florianheller/PocketLogic/docs/img/case.png

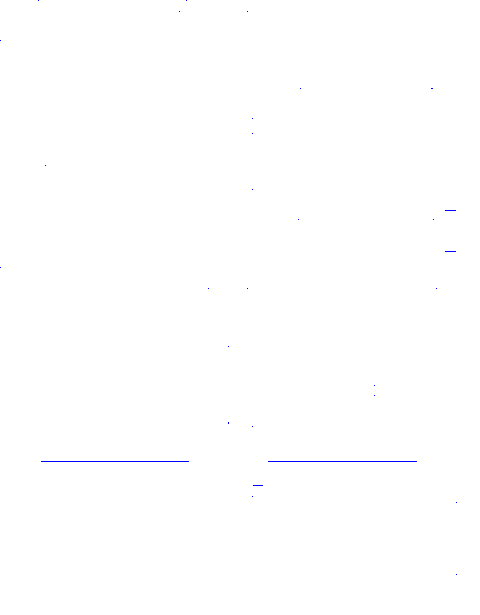
docs/img/case.png
