florianheller/PocketLogic/docs/img/schematics.pdf

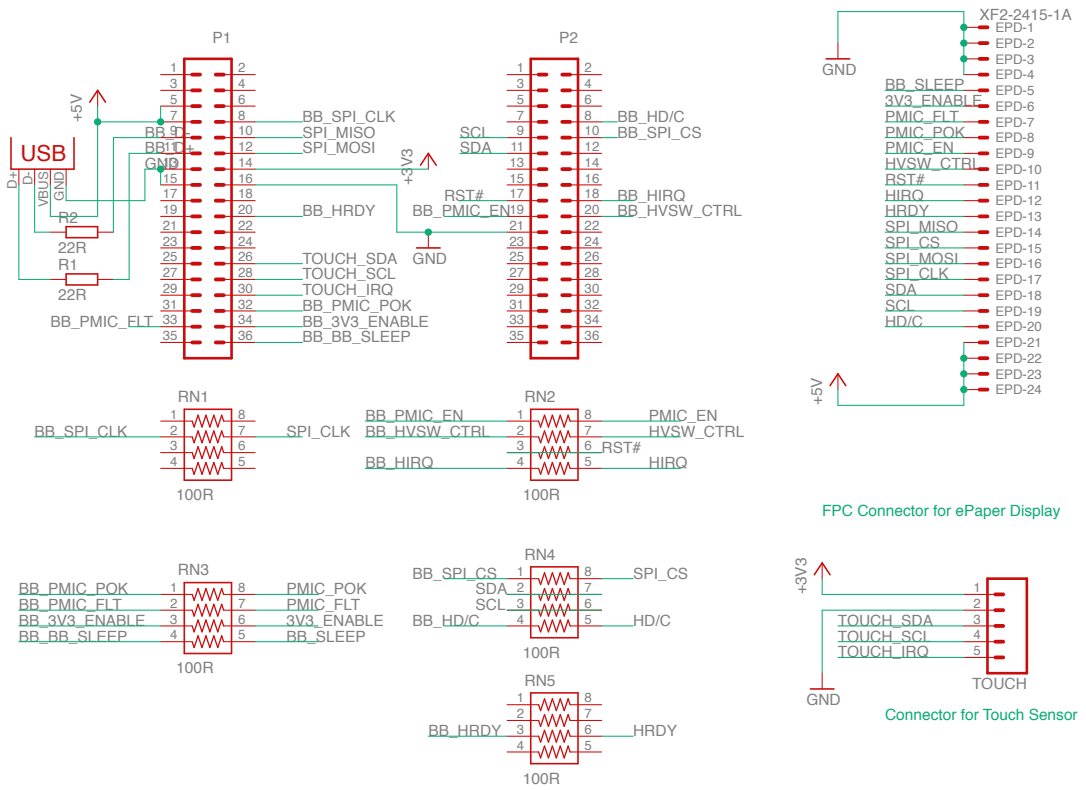
[picture p4: page 1]

FPC Connector for ePaper Display

Connector for Touch Sensor
