florianheller/PocketLogic/docs/img/board.pdf

1

36

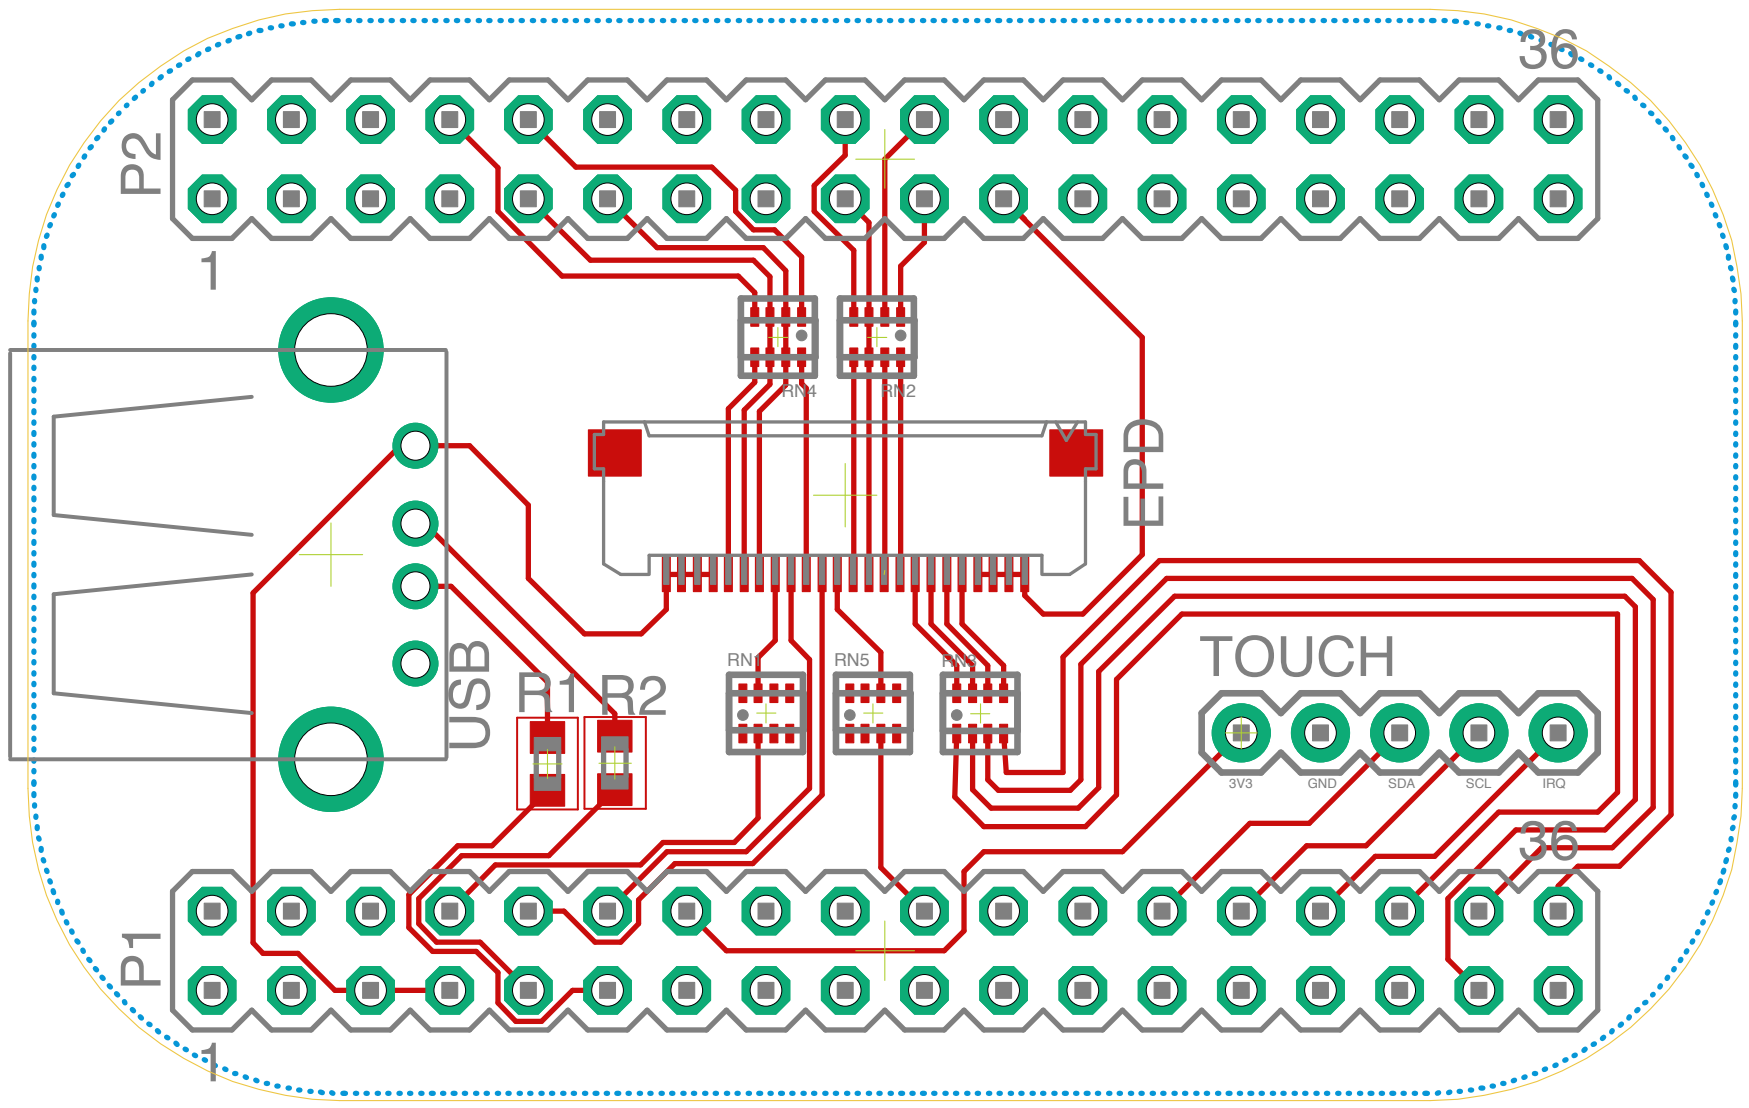
[picture p5: page 1]
