florianheller/PocketLogic/docs/resources/case.pdf

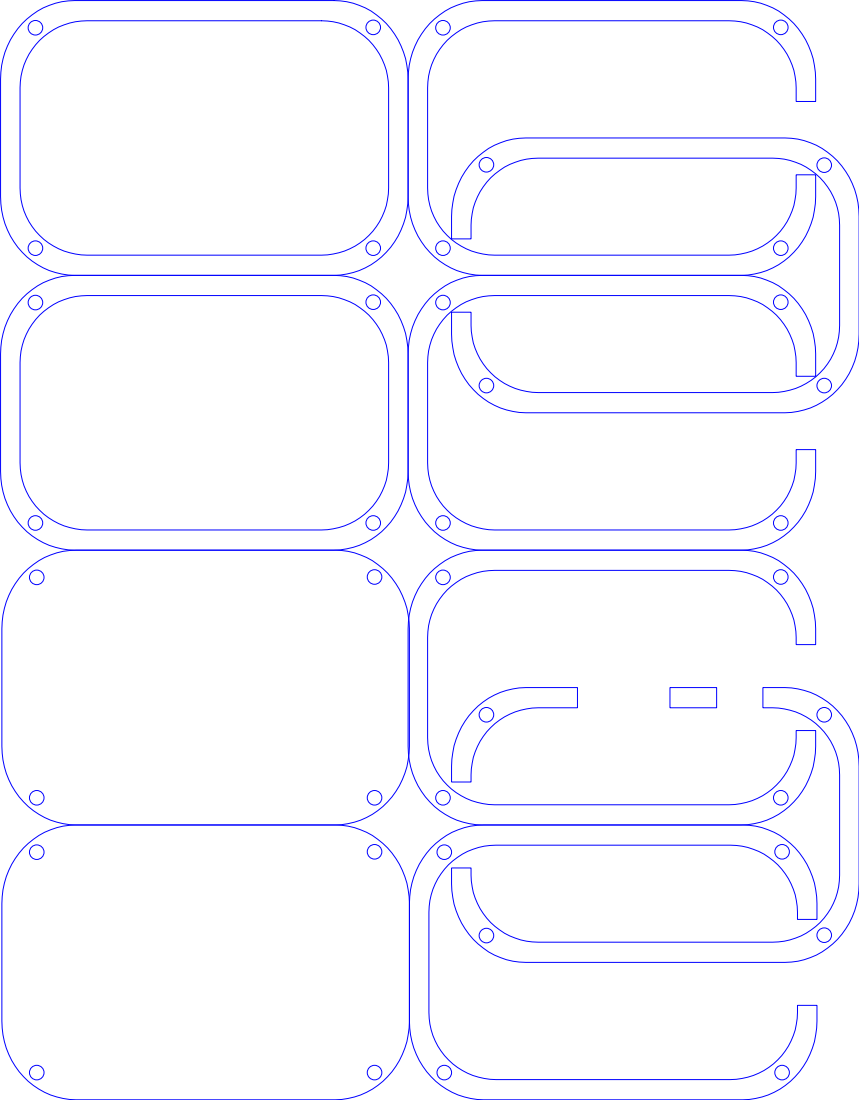
[picture p6: page 1]
