florianheller/PocketLogic/docs/resources/cape.brd

## EAGLE design docs/resources/cape.brd (2019-06-03)

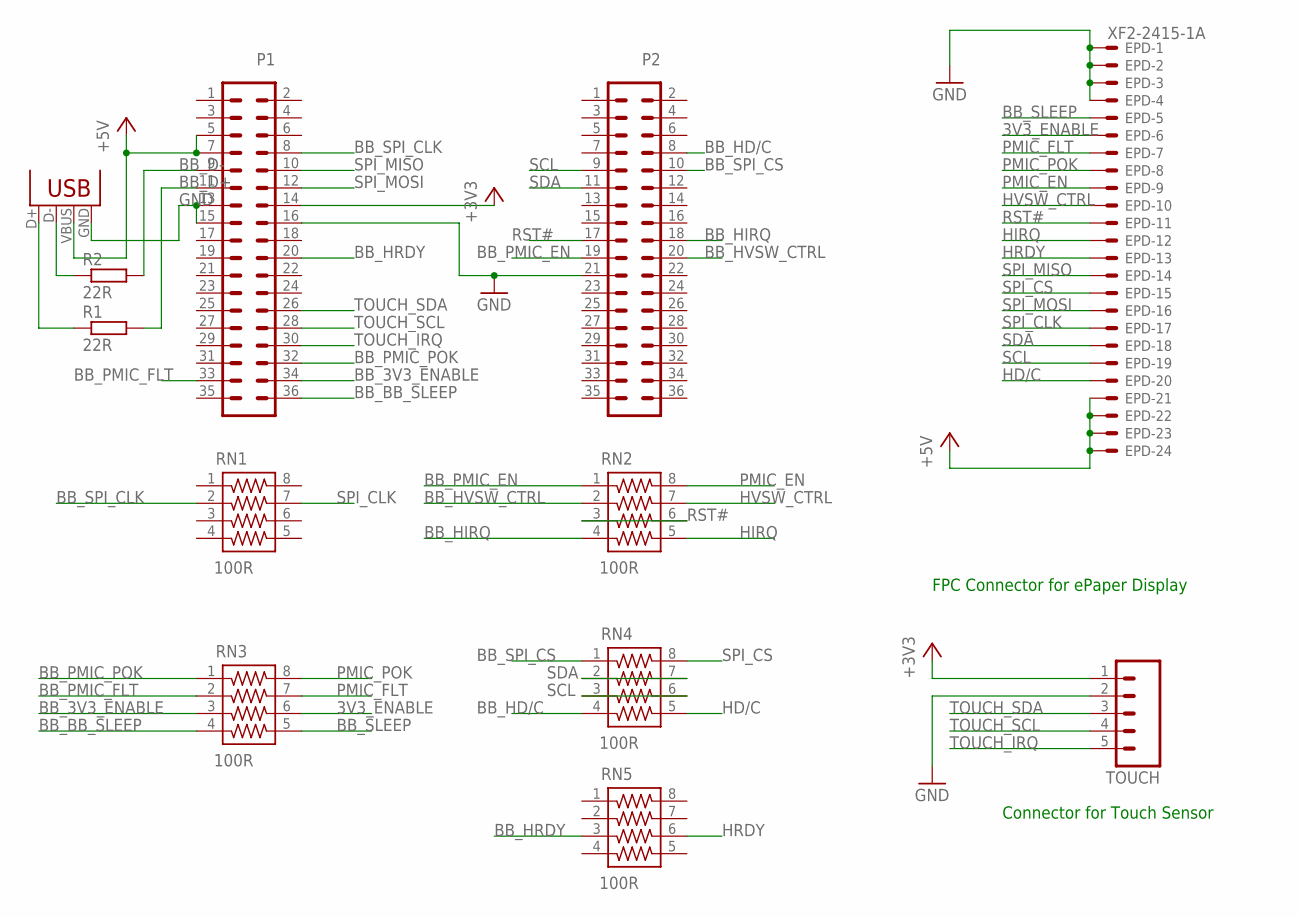
[picture p7: schematic cape.sch]

Parts:
EPD: XF2-2415-1A; XF2M-2415-1A
P1, P2: MA18-2
R1, R2: 22R; R0603
RN1, RN2, RN3, RN4, RN5: 100R; 741-8
TOUCH: M05PTH; 1X05
USB: USB-A-H

Connections:
3V3_ENABLE: EPD.6 (MS), RN3.6
+3V3: P1.14, TOUCH.1
+5V: EPD.21 (MS), EPD.22 (MS), EPD.23 (MS), EPD.24 (MS), P1.5, P1.7, USB.VBUS
BB_3V3_ENABLE: P1.34, RN3.3
BB_BB_SLEEP: P1.36, RN3.4
BB_D+: P1.11, R1.2
BB_D-: P1.9, R2.2
BB_HD/C: P2.8, RN4.4
BB_HIRQ: P2.18, RN2.4
BB_HRDY: P1.20, RN5.3
BB_HVSW_CTRL: P2.20, RN2.2
BB_PMIC_EN: P2.19, RN2.1
BB_PMIC_FLT: P1.33, RN3.2
BB_PMIC_POK: P1.32, RN3.1
BB_SLEEP: EPD.5 (MS), RN3.5
BB_SPI_CLK: P1.8, RN1.2
BB_SPI_CS: P2.10, RN4.1
D+: R1.1, USB.D+
D-: R2.1, USB.D-
GND: EPD.1 (MSV), EPD.2 (MS), EPD.3 (MS), EPD.4 (MS), P1.13, P1.15, P1.16, P2.21, TOUCH.2, USB.GND
HD/C: EPD.20 (MS), RN4.5
HIRQ: EPD.12 (MS), RN2.5
HRDY: EPD.13 (MS), RN5.6
HVSW_CTRL: EPD.10 (MS), RN2.7
PMIC_EN: EPD.9 (MS), RN2.8
PMIC_FLT: EPD.7 (MS), RN3.7
PMIC_POK: EPD.8 (MS), RN3.8
RST#: EPD.11 (MS), P2.17, RN2.3, RN2.6
SCL: EPD.19 (MS), P2.9, RN4.3, RN4.6
SDA: EPD.18 (MS), P2.11, RN4.2, RN4.7
SPI_CLK: EPD.17 (MS), RN1.7
SPI_CS: EPD.15 (MS), RN4.8
SPI_MISO: EPD.14 (MS), P1.10
SPI_MOSI: EPD.16 (MS), P1.12
TOUCH_IRQ: P1.30, TOUCH.5
TOUCH_SCL: P1.28, TOUCH.4
TOUCH_SDA: P1.26, TOUCH.3

Notes on the sheet:
Connector for Touch Sensor
FPC Connector for ePaper Display

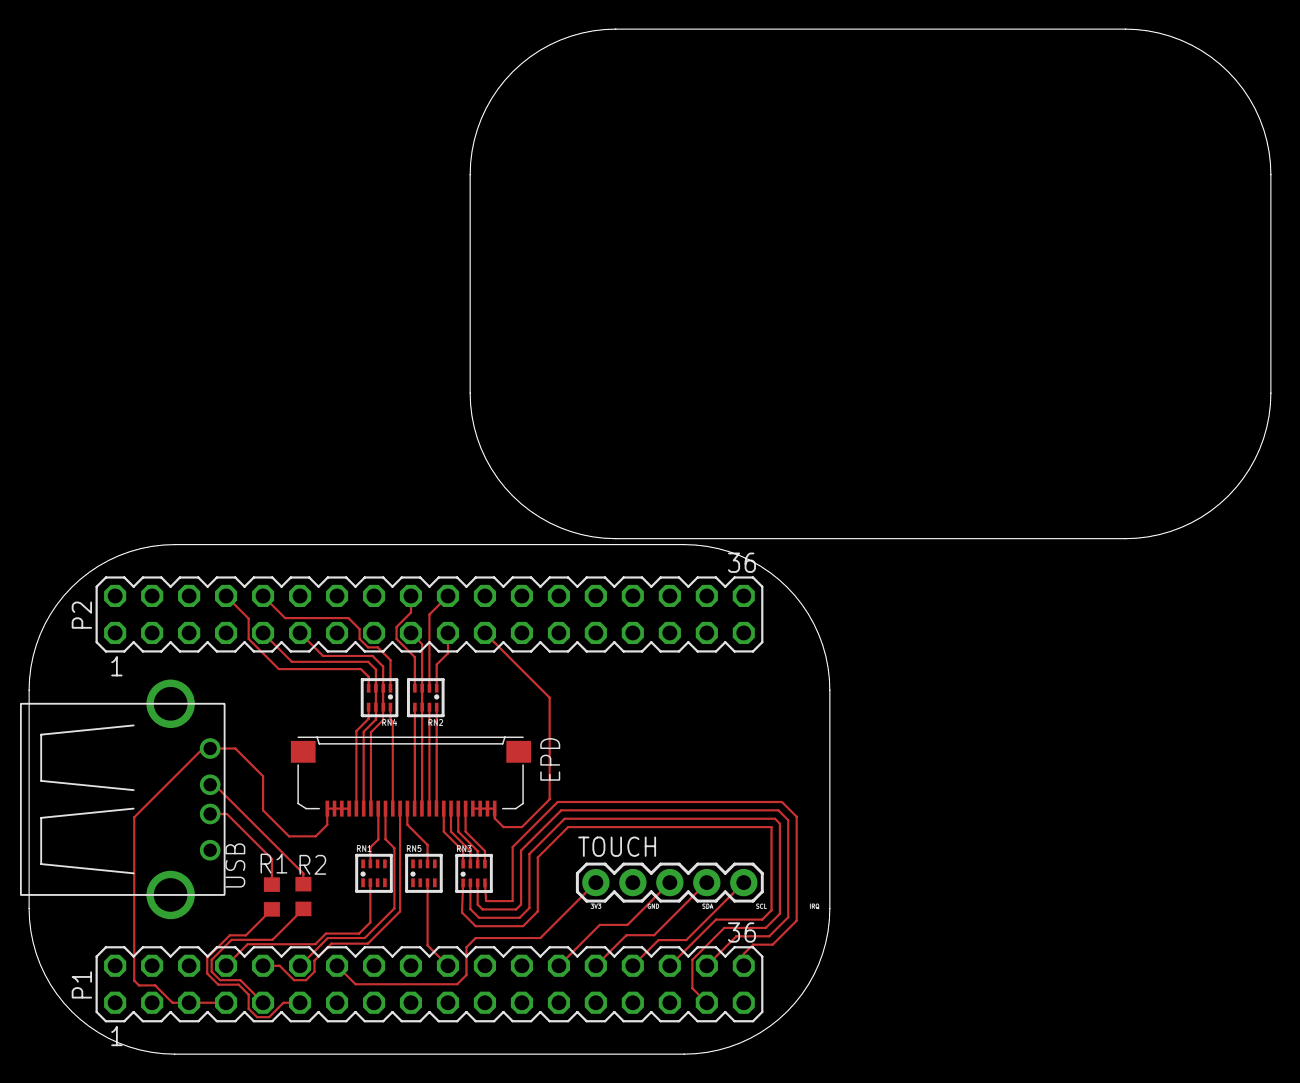
[picture p8: board cape.brd from above]

Board: 2 copper layers, 85.3 x 70.4 mm, 12 parts (0 on the bottom side), 37 nets.
