florianheller/PocketLogic/(commit log)

2019-06-03 Board data
    [cape.brd, cape.sch]
2019-06-03 Board details
2019-06-03 More details on the board
